awardblvr/SumpPumpMonitorController/docs/SumpControllerESP32-hookup.png

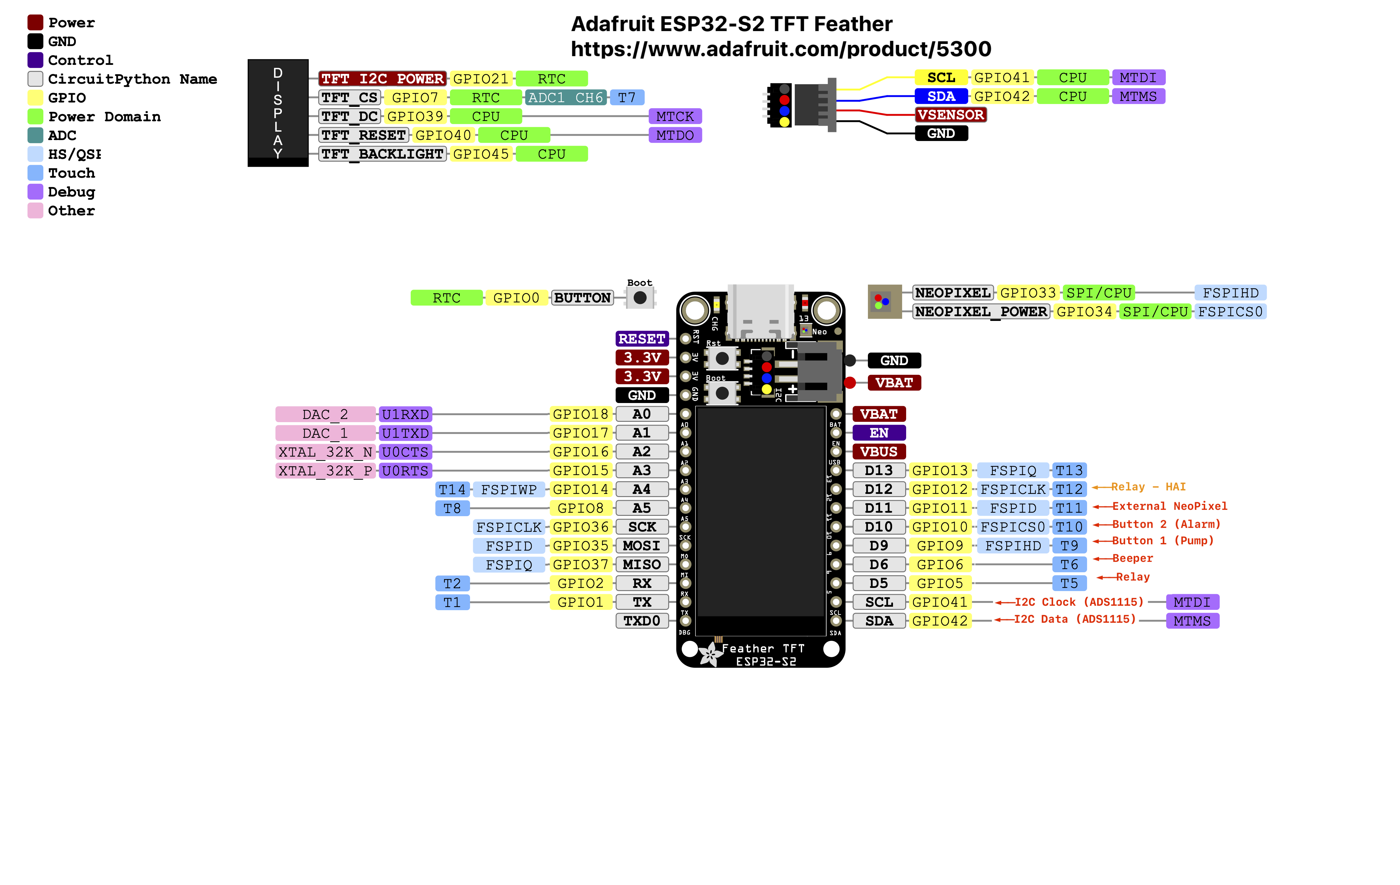
docs/SumpControllerESP32-hookup.png
